hessch/rpilink/eagle/bottom.png

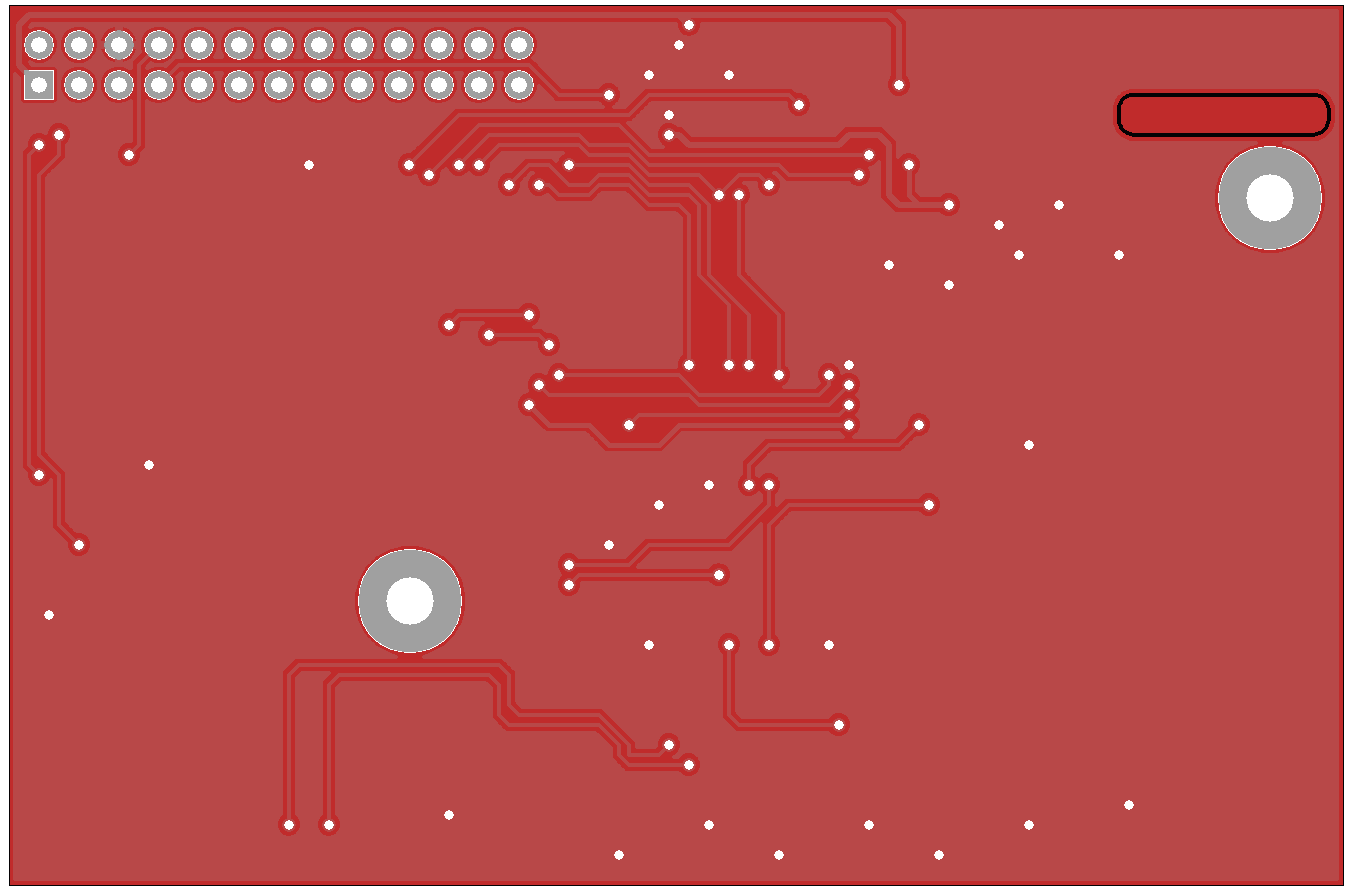
eagle/bottom.png
