hessch/rpilink/eagle/top.png

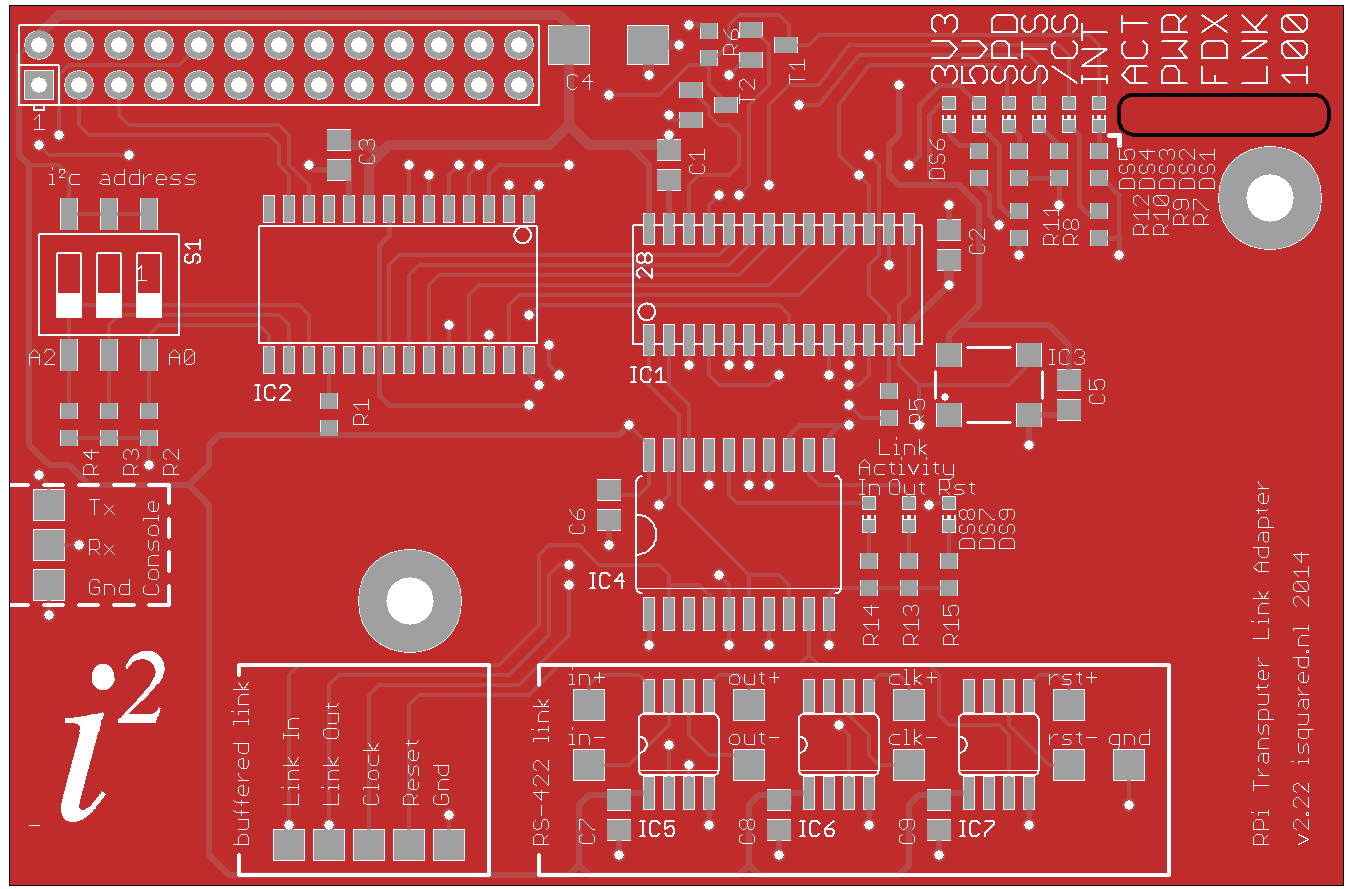
eagle/top.png
