hessch/rpilink/eagle/rpilink222.brd

## EAGLE design eagle/rpilink222.brd (2014-11-16)

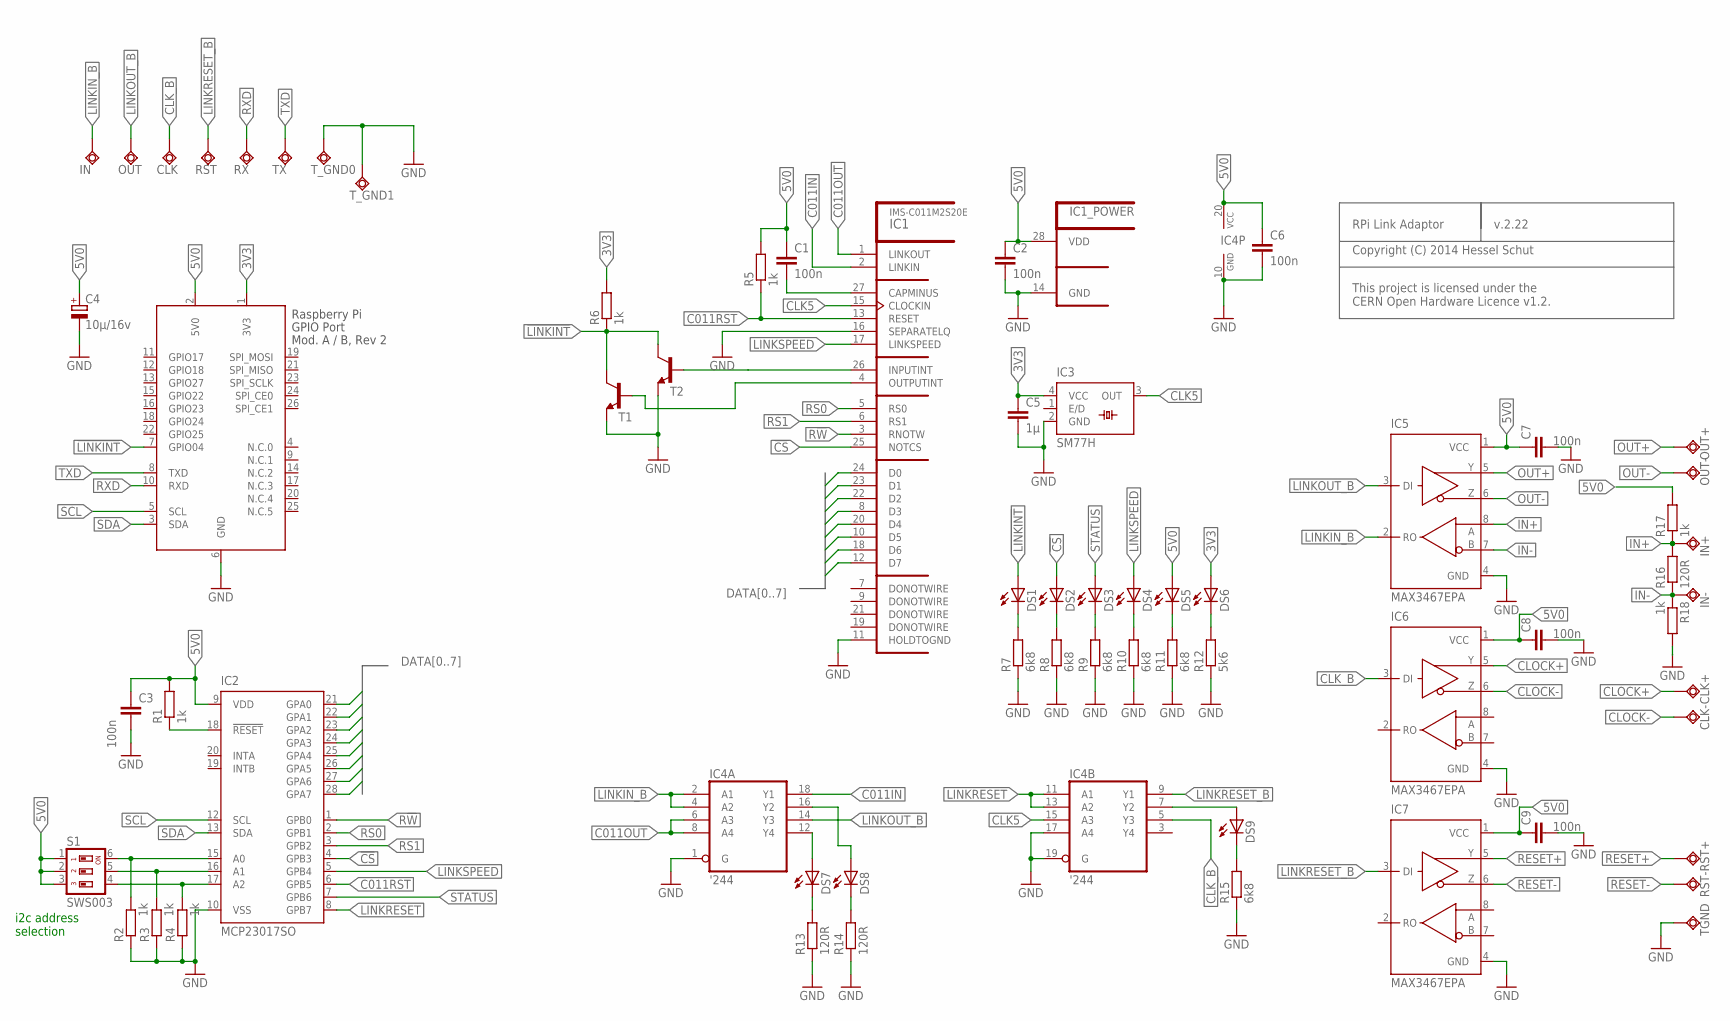
[picture p3: schematic rpilink222.sch]

Parts:
C1, C2, C3, C6, C7, C8, C9: 100n; C0805
C4: 10µ/16v; C/6032-28R
C5: 1µ; C0805
CLK: TPSQTP20SQ; TP20SQ
CLK+: TPSQTP20SQ; TP20SQ
CLK-: TPSQTP20SQ; TP20SQ
DS1, DS2, DS3, DS4, DS5, DS6, DS7, DS8, DS9: LEDCHIP-LED0603; CHIP-LED0603
IC1: IMS-C011M2S20E; SOJ28-3
IC2: MCP23017SO; SO28W
IC3: SM77H
IC4: '244; SO20W
IC5, IC6, IC7: MAX3467EPA; SO08
IN: TPSQTP20SQ; TP20SQ
IN+: TPSQTP20SQ; TP20SQ
IN-: TPSQTP20SQ; TP20SQ
OUT: TPSQTP20SQ; TP20SQ
OUT+: TPSQTP20SQ; TP20SQ
OUT-: TPSQTP20SQ; TP20SQ
R1, R2, R3, R4, R5, R6, R17, R18: 1k; R0603
R7, R8, R9, R10, R11, R15: 6k8; R0603
R12: 5k6; R0603
R13, R14, R16: 120R; R0603
RST: TPSQTP20SQ; TP20SQ
RST+: TPSQTP20SQ; TP20SQ
RST-: TPSQTP20SQ; TP20SQ
RX: TPSQTP20SQ; TP20SQ
S1: SWS003; SMS-003
T1, T2: BC808-NPN-SOT23-BEC; SOT23-BEC
TGND: TPSQTP20SQ; TP20SQ
TX: TPSQTP20SQ; TP20SQ
T_GND0, T_GND1: TPSQTP20SQ; TP20SQ
X1: RASPI_BOARD_AB_E2P; RASPI_BOARD_AB_EDGES_2DRILL_PAD

Connections:
3V3: C5.1, DS6.A, IC3.4 (VCC), R6.2, X1.1 (3V3)
5V0: C1.1, C2.1, C3.1, C4.+, C6.1, C7.1, C8.1, C9.1, DS5.A, IC1.28 (VDD), IC2.9 (VDD), IC4.20 (VCC), IC5.1 (VCC), IC6.1 (VCC), IC7.1 (VCC), R1.2, R5.2, R17.2, S1.1, S1.2, S1.3, X1.2 (5V0)
!CS: DS2.A, IC1.25 (NOTCS), IC2.4 (GPB3)
!LINKINT: DS1.A, R6.1, T1.C, T2.C, X1.7 (GPIO04)
C011IN: IC1.2 (LINKIN), IC4.18 (Y1)
C011OUT: IC1.1 (LINKOUT), IC4.6 (A3), IC4.8 (A4)
C011RST: IC1.13 (RESET), IC2.6 (GPB5), R5.1
CLK5: IC1.15 (CLOCKIN), IC3.3 (OUT), IC4.15 (A3)
CLK_B: CLK.TP, IC4.5 (Y3), IC6.3 (DI)
CLOCK+: CLK+.TP, IC6.5 (Y)
CLOCK-: CLK-.TP, IC6.6 (Z)
DATA0: IC1.24 (D0), IC2.21 (GPA0)
DATA1: IC1.23 (D1), IC2.22 (GPA1)
DATA2: IC1.22 (D2), IC2.23 (GPA2)
DATA3: IC1.8 (D3), IC2.24 (GPA3)
DATA4: IC1.20 (D4), IC2.25 (GPA4)
DATA5: IC1.10 (D5), IC2.26 (GPA5)
DATA6: IC1.18 (D6), IC2.27 (GPA6)
DATA7: IC1.12 (D7), IC2.28 (GPA7)
GND: C2.2, C3.2, C4.-, C5.2, C6.2, C7.2, C8.2, C9.2, IC1.11 (HOLDTOGND), IC1.14 (GND), IC1.16 (SEPARATELQ), IC2.10 (VSS), IC3.2 (GND), IC4.1 (G), IC4.10 (GND), IC4.17 (A4), IC4.19 (G), IC5.4 (GND), IC6.4 (GND), IC7.4 (GND), R2.1, R3.1, R4.1, R7.1, R8.1, R9.1, R10.1, R11.1, R12.1, R13.1, R14.1, R15.1, R18.2, T1.E, T2.E, TGND.TP, T_GND0.TP, T_GND1.TP, X1.6 (GND)
IN+: IC5.8 (A), IN+.TP, R16.2, R17.1
IN-: IC5.7 (B), IN-.TP, R16.1, R18.1
LINKIN_B: IC4.2 (A1), IC4.4 (A2), IC5.2 (RO), IN.TP
LINKOUT_B: IC4.14 (Y3), IC5.3 (DI), OUT.TP
LINKRESET: IC2.8 (GPB7), IC4.11 (A1), IC4.13 (A2)
LINKRESET_B: IC4.9 (Y1), IC7.3 (DI), RST.TP
LINKSPEED: DS4.A, IC1.17 (LINKSPEED), IC2.5 (GPB4)
unnamed: IC2.18 (!RESET), R1.1
unnamed: IC2.15 (A0), R2.2, S1.6
unnamed: C1.2, IC1.27 (CAPMINUS)
unnamed: IC2.16 (A1), R3.2, S1.5
unnamed: IC2.17 (A2), R4.2, S1.4
unnamed: IC1.26 (INPUTINT), T2.B
unnamed: IC1.4 (OUTPUTINT), T1.B
unnamed: DS7.C, R13.2
unnamed: DS8.C, R14.2
unnamed: DS7.A, IC4.12 (Y4)
unnamed: DS1.C, R7.2
unnamed: DS2.C, R8.2
unnamed: DS3.C, R9.2
unnamed: DS4.C, R10.2
unnamed: DS5.C, R11.2
unnamed: DS6.C, R12.2
unnamed: DS8.A, IC4.16 (Y2)
unnamed: DS9.A, IC4.7 (Y2)
unnamed: DS9.C, R15.2
OUT+: IC5.5 (Y), OUT+.TP
OUT-: IC5.6 (Z), OUT-.TP
R!W: IC1.3 (RNOTW), IC2.1 (GPB0)
RESET+: IC7.5 (Y), RST+.TP
RESET-: IC7.6 (Z), RST-.TP
RS0: IC1.5 (RS0), IC2.2 (GPB1)
RS1: IC1.6 (RS1), IC2.3 (GPB2)
RXD: RX.TP, X1.10 (RXD)
SCL: IC2.12 (SCL), X1.5 (SCL)
SDA: IC2.13 (SDA), X1.3 (SDA)
STATUS: DS3.A, IC2.7 (GPB6)
TXD: TX.TP, X1.8 (TXD)

Notes on the sheet:
i2c address selection
RPi Link Adaptor
v.2.22
Copyright (C) 2014 Hessel Schut
This project is licensed under the CERN Open Hardware Licence v1.2.

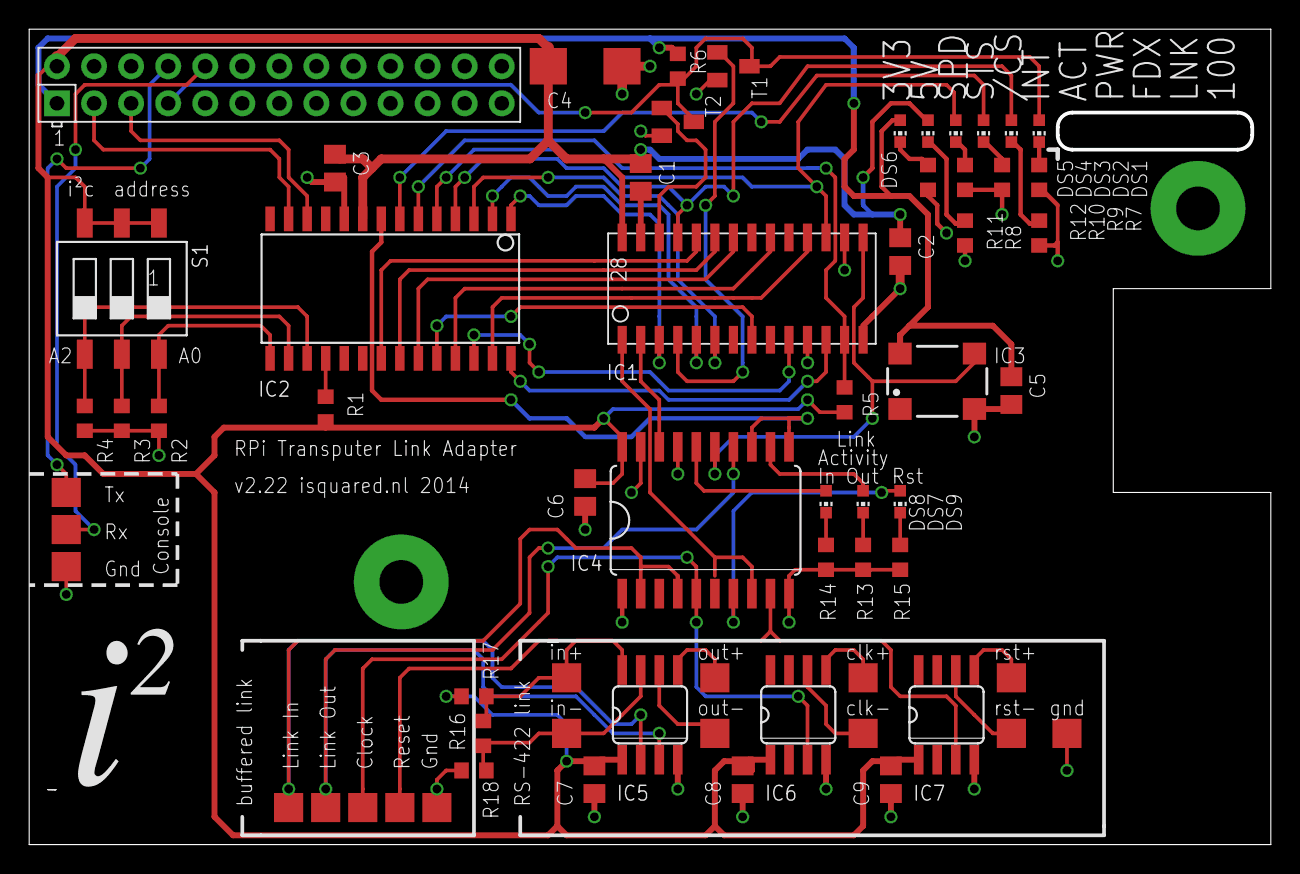
[picture p4: board rpilink222.brd from above]

Board: 2 copper layers, 85.1 x 55.9 mm, 65 parts (0 on the bottom side), 58 nets.

Other parts of the board:
U$1: LOGOWOBLRG
