hessch/rpilink/(commit log)

2014-06-28 Addedd proper control pin assignments.
2014-06-28 Add LED indication to write_byte().
2014-07-04 Led indictaion on reset
    [Inmos.py]
2014-10-17 Fixed copy-paste boo boo.
    [MCP23017.py]
2014-11-06 Added Eagle files. Moved linktest and tdetect to utils.
    [rpilink222.brd, rpilink222.sch]
2014-11-06 PCB pictures added
2014-11-06 Updated signals for board version 2.22. Added link reset.
    [rpilink222.sch]
2014-11-07 Added CERN_OHR license information.
    [rpilink222.sch]
2014-11-13 Added component values, added rs-422 bias resistors.
    [rpilink222.brd, rpilink222.sch]
2014-11-16 usb cut-out
    [rpilink222.brd]
